Uvindu/Proximity_Meter/(list of files, cad)

Other CAD files:
MPLABX_Files - Code/analog_input.X/dist/default/production/analog_input.X.production.obj
MPLABX_Files - Code/keypad_test.X/dist/default/production/keypad_test.X.production.obj
MPLABX_Files - Code/LCD16x2.X/dist/default/production/LCD16x2.X.production.obj
MPLABX_Files - Code/led_blink.X/dist/default/production/led_blink.X.production.obj
MPLABX_Files - Code/pwm_low_freq.X/dist/default/production/pwm_low_freq.X.production.obj
MPLABX_Files - Code/sharp_test.X/dist/default/production/sharp_test.X.production.obj
MPLABX_Files - Code/u_sonic.X/dist/default/production/u_sonic.X.production.obj
