Uvindu/Proximity_Meter/(list of files, drawings)

Other design files:
PCB 1 - first attempt/group-16.pdsprj
PCB 2 - second attempt/New Project.pdsprj
